adafruit/Adafruit-SGP40-PCB/Adafruit SGP40.brd

## EAGLE design Adafruit SGP40.brd (2020-12-08)

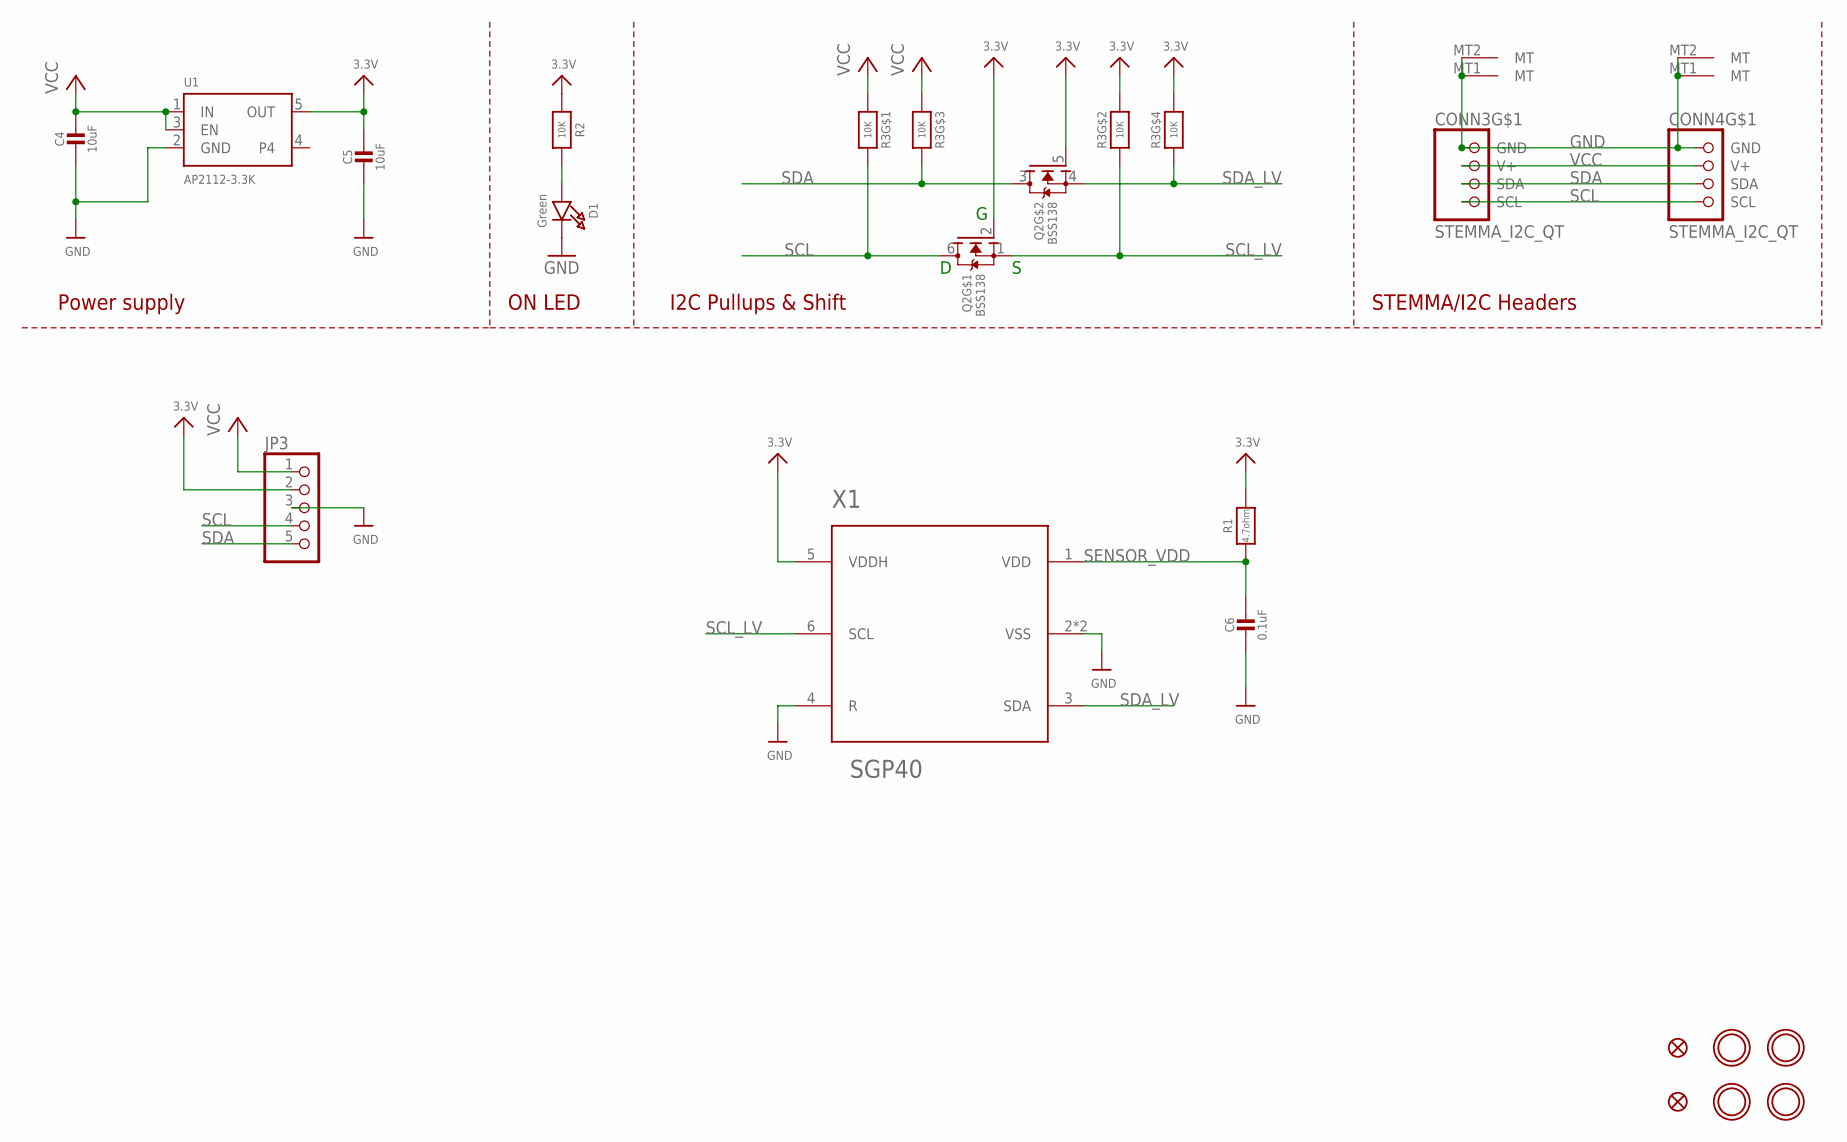
[picture p2: schematic Adafruit SGP40.sch]

Parts:
C4, C5: 10uF; 0805-NO
C6: 0.1uF; 0603-NO
CONN3, CONN4: STEMMA_I2C_QT; JST_SH4
D1: Green; CHIPLED_0603_NOOUTLINE
FID3, FID4: FIDUCIAL_1MM
JP3: HEADER-1X570MIL; 1X05_ROUND_70
Q2: BSS138; SOT363
R1: 4.7ohm; 0603-NO
R2: 10K; 0603-NO
R3: 10K; RESPACK_4X0603
U1: AP2112-3.3K; SOT23-5
U$28, U$29, U$31, U$32: MOUNTINGHOLE2.5; MOUNTINGHOLE_2.5_PLATED
X1: SGP40; SGP30

Connections:
3.3V: C5.1, JP3.2, Q2.2 (G), Q2.5 (G), R1.2, R2.1, R3.2 (1), R3.4 (1), U1.5 (OUT), X1.5 (VDDH)
GND: C4.2, C5.2, C6.2, CONN3.1 (GND), CONN3.MT1 (MT), CONN3.MT2 (MT), CONN4.1 (GND), CONN4.MT1 (MT), CONN4.MT2 (MT), D1.C, JP3.3, U1.2 (GND), X1.2 (VSS), X1.4 (R), X1.P$7 (VSS)
unnamed: D1.A, R2.2
SCL: CONN3.4 (SCL), CONN4.4 (SCL), JP3.4, Q2.6 (D), R3.8 (2)
SCL_LV: Q2.1 (S), R3.7 (2), X1.6 (SCL)
SDA: CONN3.3 (SDA), CONN4.3 (SDA), JP3.5, Q2.3 (D), R3.6 (2)
SDA_LV: Q2.4 (S), R3.5 (2), X1.3 (SDA)
SENSOR_VDD: C6.1, R1.1, X1.1 (VDD)
VCC: C4.1, CONN3.2 (V+), CONN4.2 (V+), JP3.1, R3.1, R3.3 (1), U1.1 (IN), U1.3 (EN)

Notes on the sheet:
I2C Pullups & Shift
STEMMA/I2C Headers
ON LED
Power supply

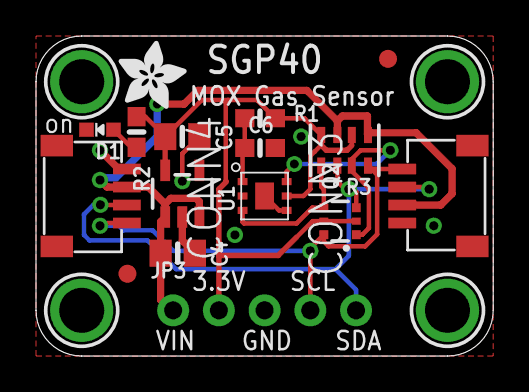
[picture p3: board Adafruit SGP40.brd from above]

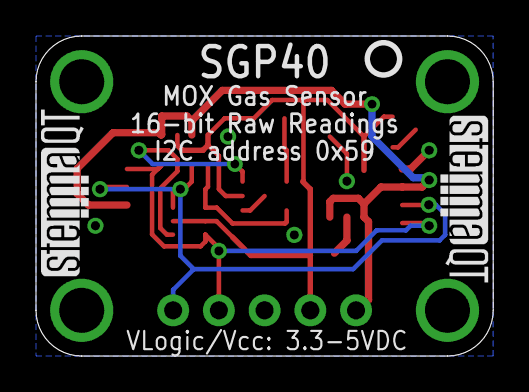
[picture p4: board Adafruit SGP40.brd from below]

Board: 2 copper layers, 25.4 x 17.8 mm, 23 parts (3 on the bottom side), 9 nets.

Other parts of the board:
U$34: ADAFRUIT_3.5MM
U$35: PCBFEAT-REV-040
U$36, U$37: STEMMAQT
